open-ephys/onix-headstage-64s/README.md

# ONIX Simplified 64-Channel Headstage
Serialized, multifunction headstage for wire electrode or silicon probe recordings.

- 64x electrophysiology channels
- 3x auxiliary analog channels
- Integrated real-time, room-scale 3D-position tracking
- Integrated absolute orientation tracking
