open-ephys/onix-headstage-64s/pcb/manufacturing/pcb-fabrication-specs.md

# PCB Fabrication Specifications

## Panel
- Fabricator makes panel as 1x5 with V-Cuts
- Fabricator adds frame and fiducial marks
- Fabricator markings allowed on frame

## Stackup
- layer "F.Cu" 
    - type "copper" 
    - Thickness 0.035 mm
- layer "Dielectric 1" 
    - type "prepreg" 
    - Thickness 0.112 mm 
- layer "In1.Cu" 
    - type "copper" 
    - Thickness 0.035 mm
- layer "Dielectric 2" 
    - type "prepreg" 
    - Thickness 0.0329 mm 
- layer "In2.Cu" 
    - type "copper" 
    - Thickness 0.035 mm
- layer "Dielectric 3" 
    - type "core" 
    - Thickness 0.0656 mm 
- layer "In3.Cu" 
    - type "copper" 
    - Thickness 0.035 mm
- layer "Dielectric 4" 
    - type "prepreg" 
    - Thickness 0.0329 mm 
- layer "In4.Cu" 
    - type "copper" 
    - Thickness 0.035 mm
- layer "Dielectric 5" 
    - type "prepreg 
    - Thickness 0.112 mm 
- layer "B.Cu" 
    - type "copper" 
    - Thickness 0.035 mm

- Total thickness: ~0.6mm

## Trace space
- Trace: 0.0762 mm
- Space: 0.0762 mm

## Vias
- Through vias: 241
- Blind/buried: 0
- Micro vias: 0
- VIP
- Vias are epoxy-filled and and plated over

## Drill holes
| Count | Shape | X Size | Y Size | Plated | Via/Pad | Start Layer | Stop Layer |
|---|---|---|---|---|---|---|---|
| 200 | Round | 0.1000 mm | 0.1000 mm | PTH | Via | F.Cu | B.Cu |
| 41 | Round | 0.2000 mm | 0.2000 mm | PTH | Via | F.Cu | B.Cu |
| 10 | Round | 1.0000 mm | 1.0000 mm | PTH | Pad | F.Cu | B.Cu |
