open-ephys/onix-headstage-64s/(threads)

Thread 1 (2024-02-23):

Fix BNO055 symbol error

jonnew, 2024-02-23:
As noted in [this commit ](https://github.com/open-ephys/open-ephys-kicad-library/commit/a86a1528330b028d3558035a07ae2cf99dc39085), the official KiCAD BNO055 symbol had a major error that ended up tying two pins (15 and 16) to ground that should be DNC. This needs to be fixed in the schematic, pcb, and production files and will result in a new PCB revision.

Closed 2025-02-04.
