open-ephys/onix-headstage-64s/pcb/headstage-64s.pdf

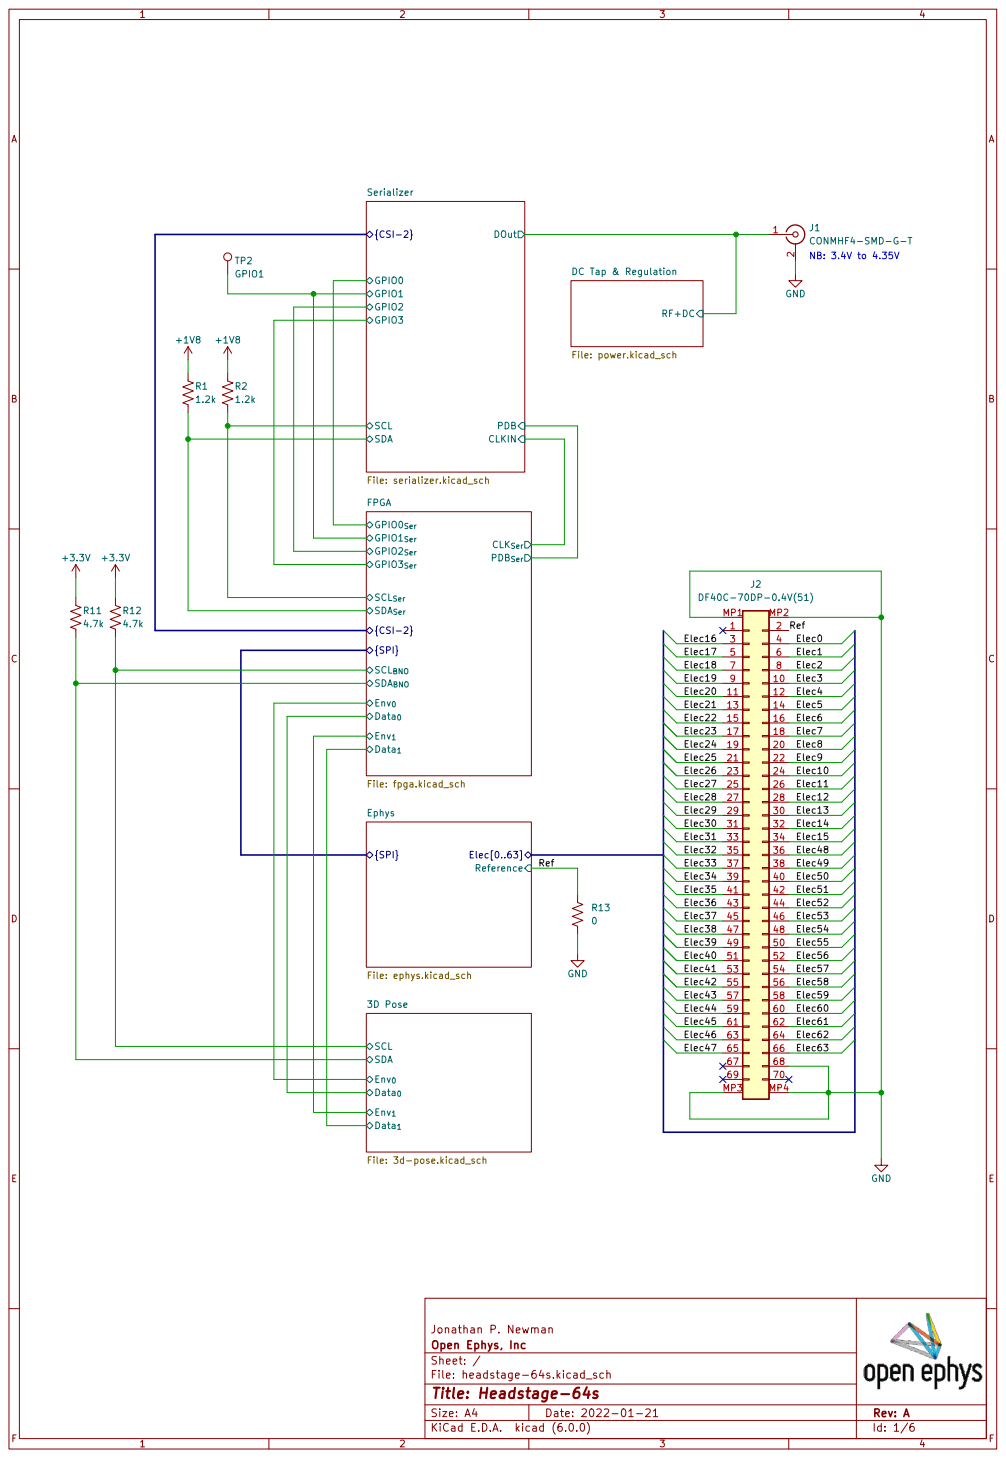
[picture p1: page 1]

Jonathan P. Newman SCL SDA

File: headstage-64s.kicad_sch Sheet: / Open Ephys, Inc

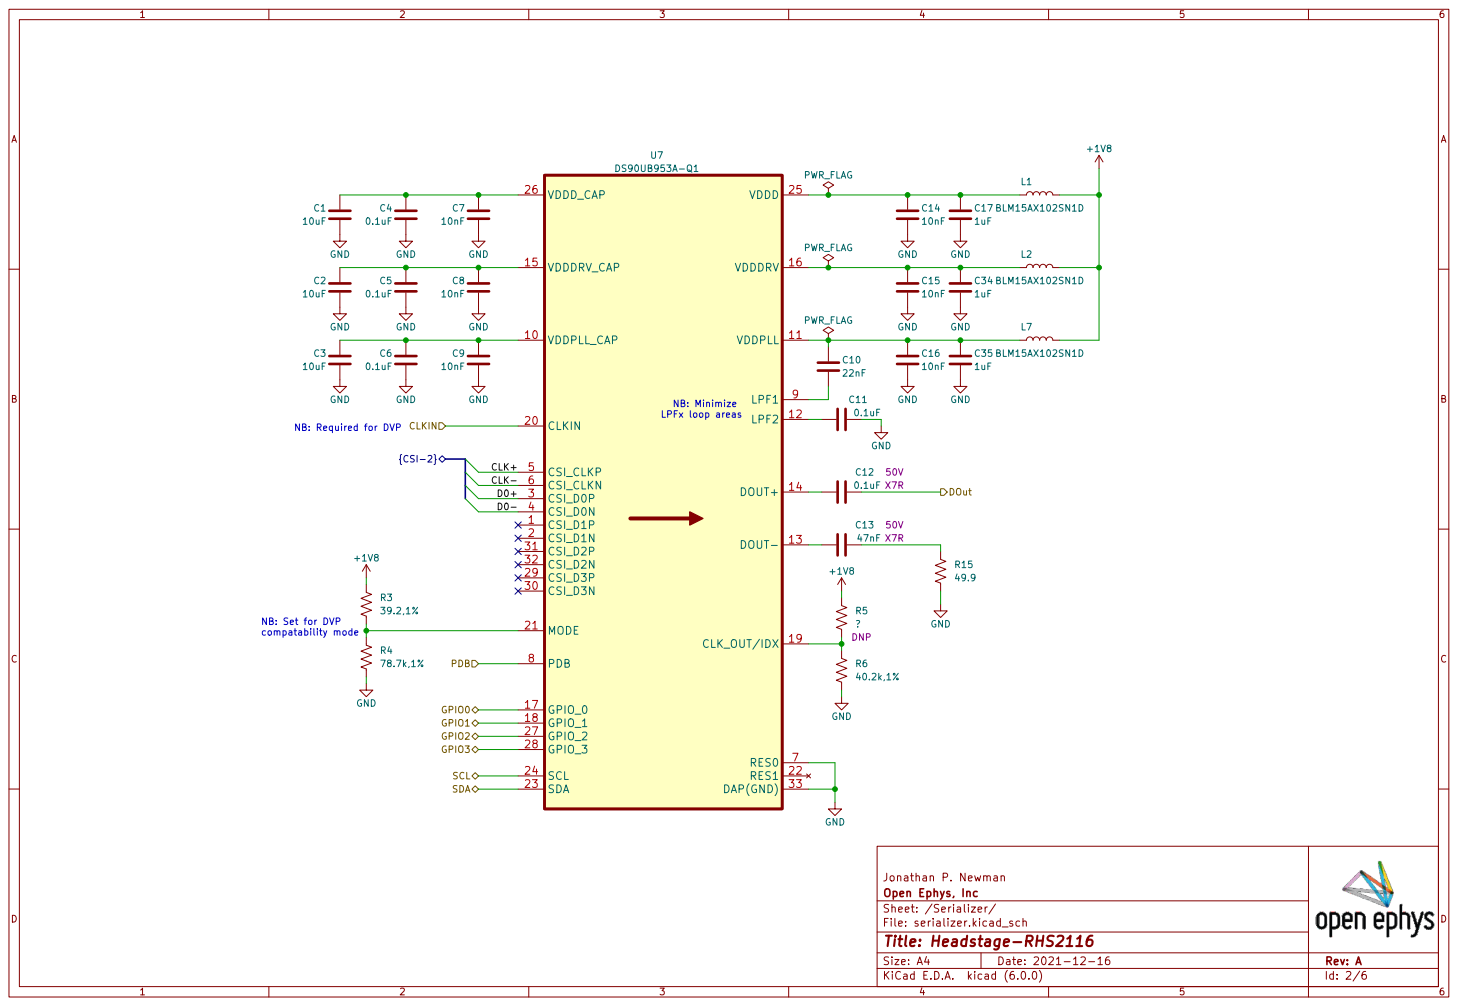
[picture p2: page 2]

PWR_FLAG | 1uF C14

1uF GND

Jonathan P. Newman GND GND

File: serializer.kicad_sch Sheet: /Serializer/ Open Ephys, Inc

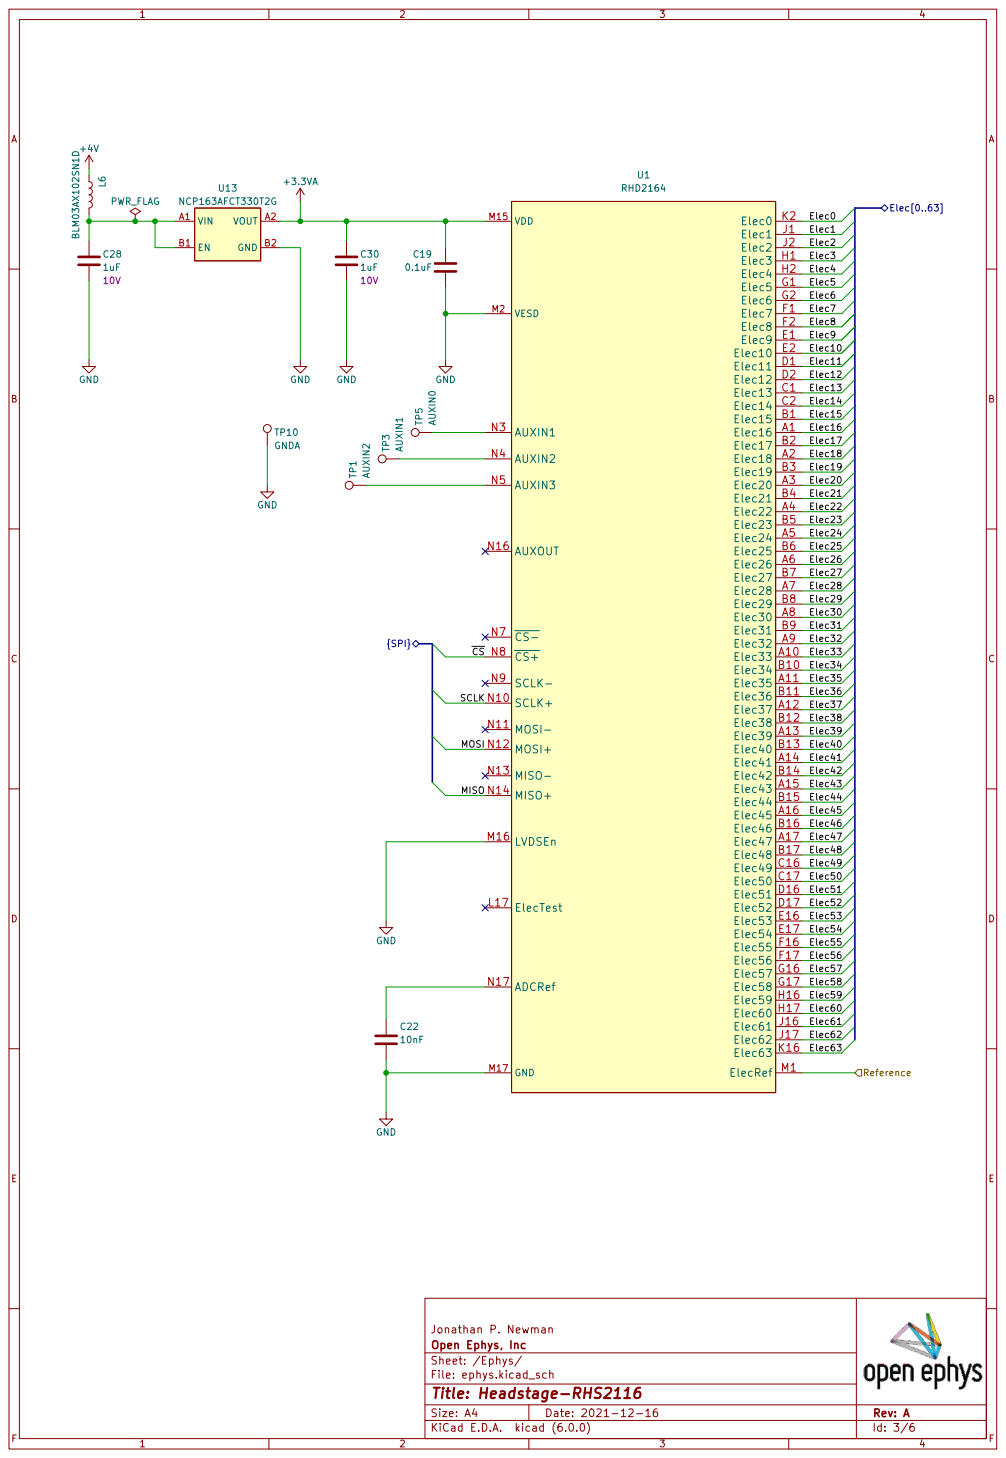
[picture p3: page 3]

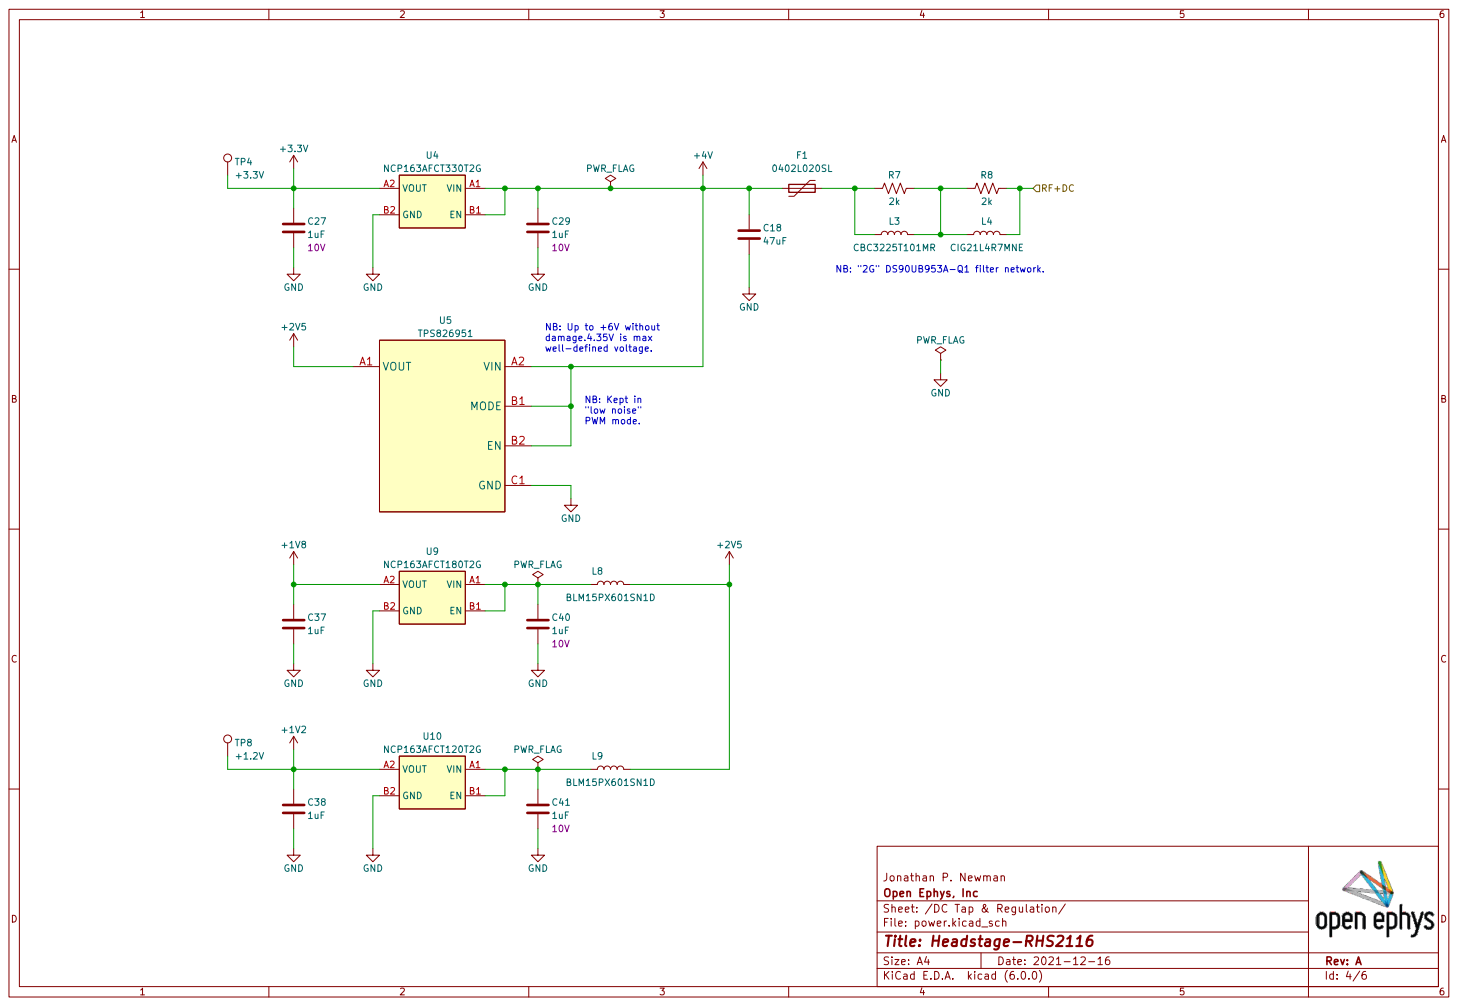
[picture p4: page 4]

NB: Up to +6V without
damage.4.35V is max

"low noise" PWM mode.

Open Ephys, Inc
Sheet: /DC Tap & Regulation/
File: power.kicad_sch
Id: 4/6 Title: Headstage-RHS2116

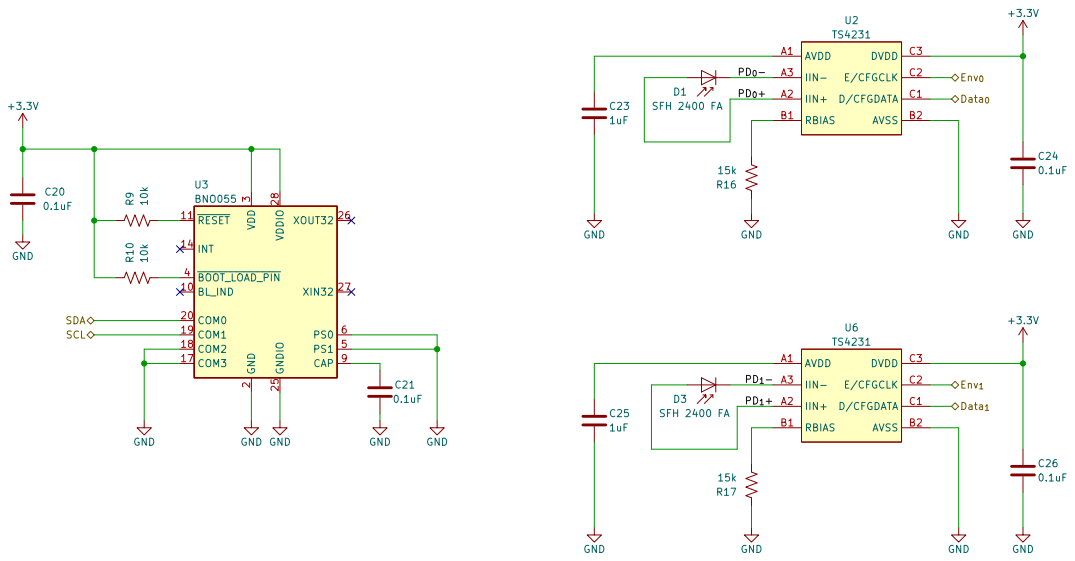
[picture p5: page 5]

File: 3d-pose.kicad_sch Sheet: /3D Pose/ Open Ephys, Inc

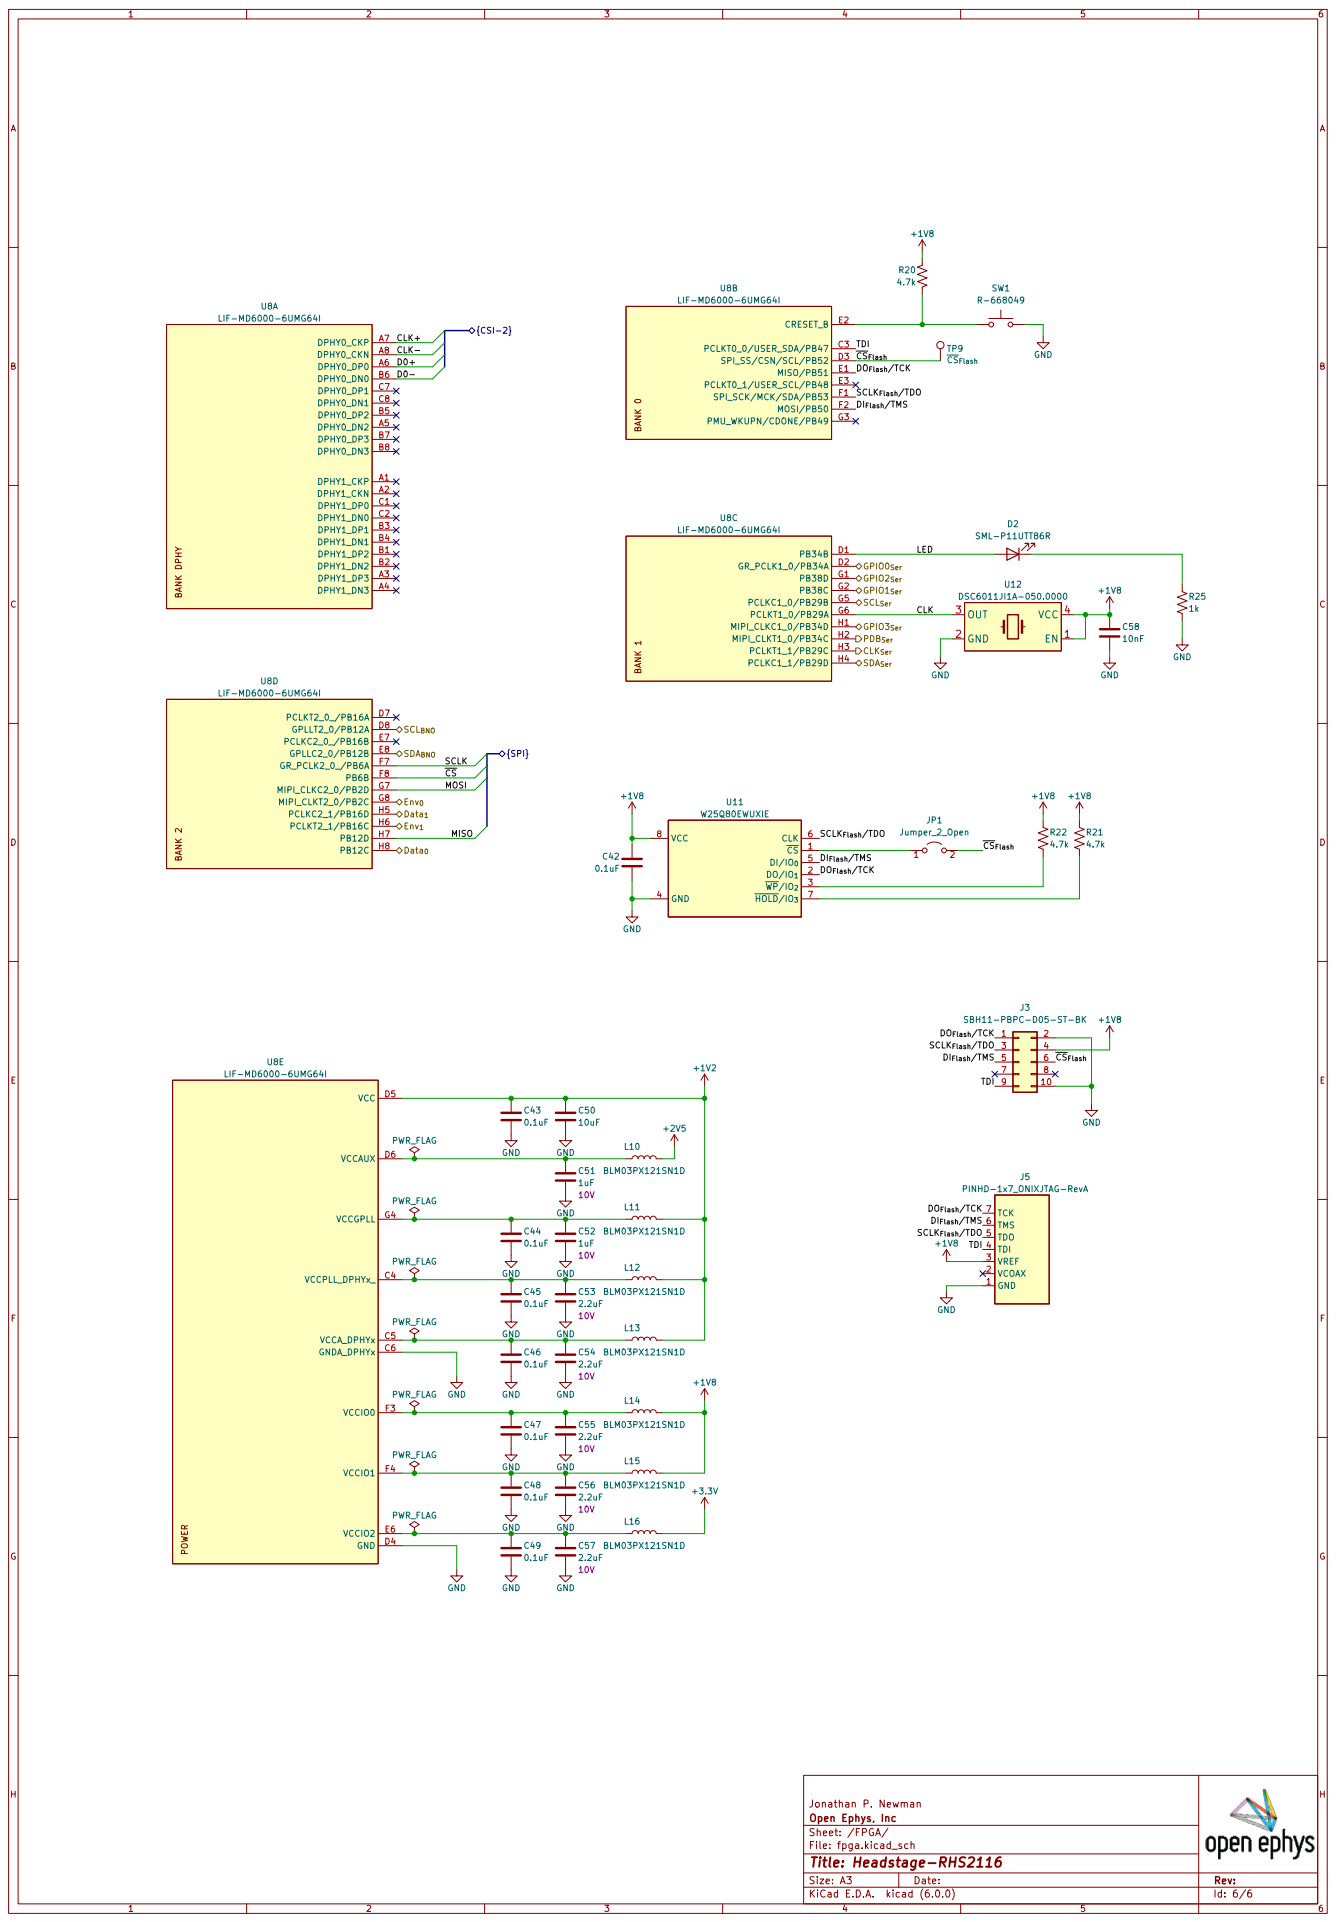
[picture p6: page 6]

SCL_{BNO}
SCLK MOSI ~{CS} MISO

PWR_FLAG | 0.1uF C45

PWR_FLAG | | 10V GND

Jonathan P. Newman
File: fpga.kicad_sch Sheet: /FPGA/ Open Ephys, Inc
