open-ephys/onix-headstage-64s/pcb/headstage-64s.kicad_pcb

## KiCad design pcb/headstage-64s.kicad_pcb (2022-12-06)

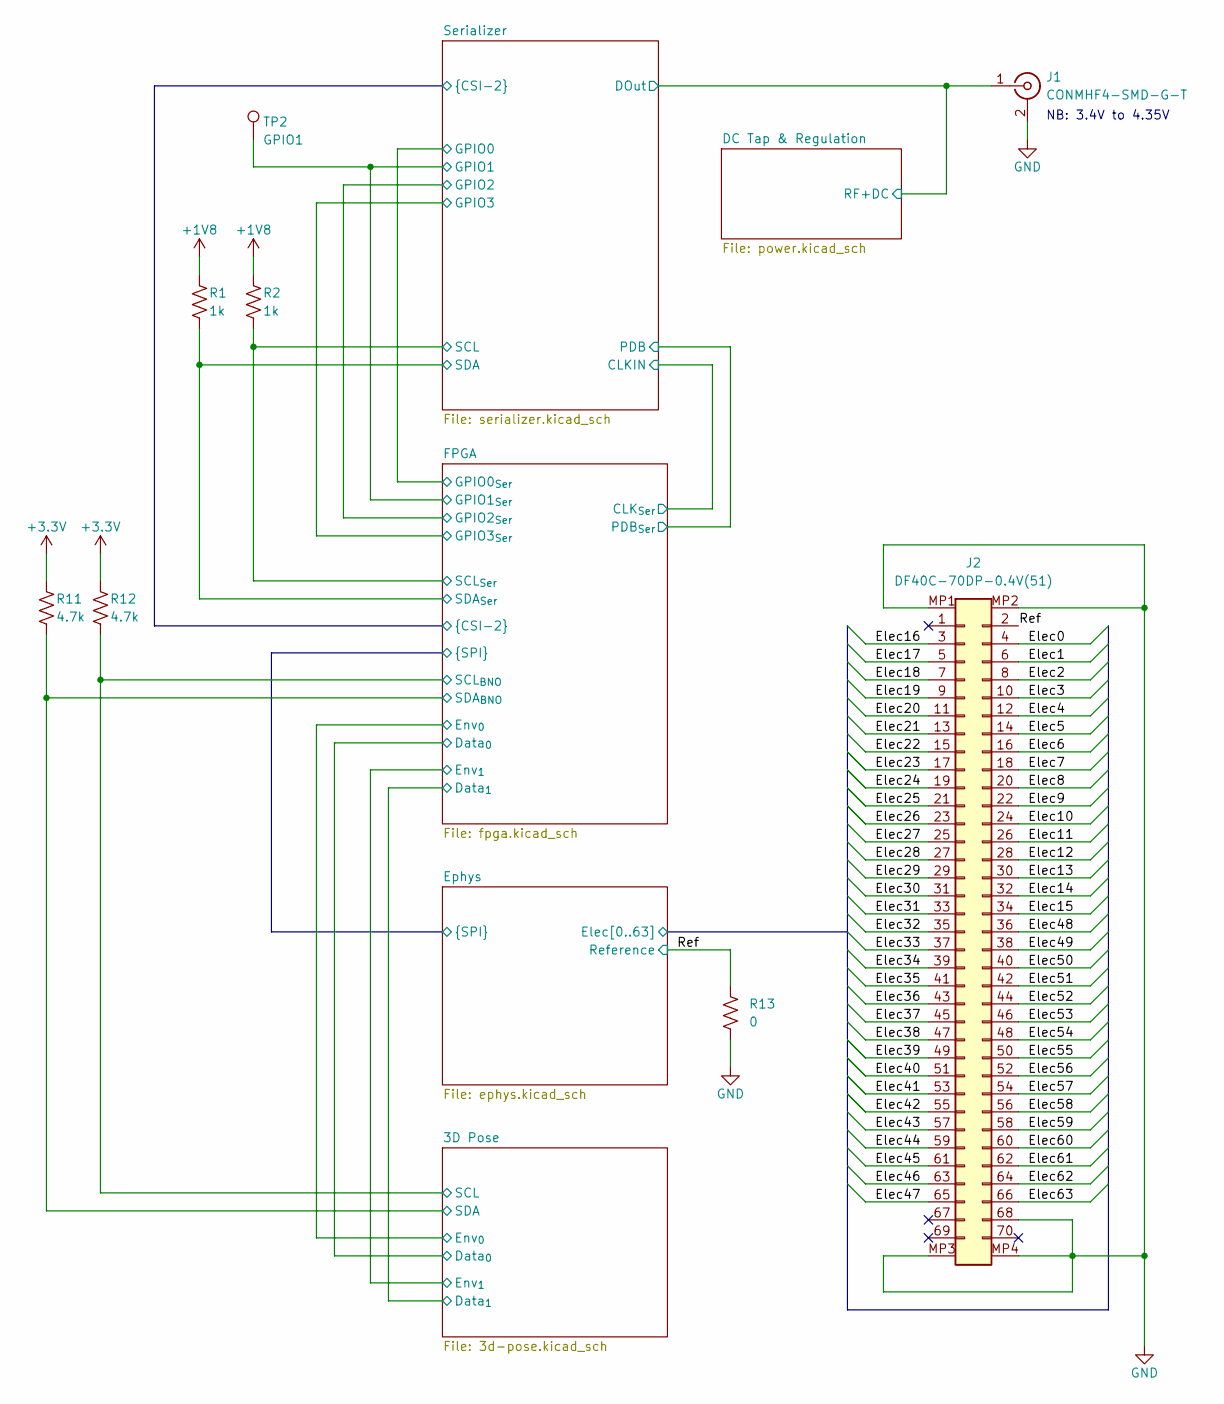
[picture p7: schematic headstage-64s.kicad_sch]

Parts:
J1: CONMHF4-SMD-G-T; Coax-Adapter
J2: DF40C-70DP-0.4V(51); HIROSE_DF40C70DP04V51
R1, R2: 1k; R_0201_0603Metric
R11, R12: 4.7k; R_0201_0603Metric
R13: 0; R_0201_0603Metric
TP2: GPIO1; TestPoint_Pad_D0.6mm

Connections:
+1V8: R1.1, R2.1; also elsewhere on the board
+3V3: R11.1, R12.1; also elsewhere on the board
/3D Pose/SCL: R12.2; also elsewhere on the board
/3D Pose/SDA: R11.2; also elsewhere on the board
/DC Tap & Regulation/RF+DC: J1.1 (In); also elsewhere on the board
/Ephys/Elec0: J2.4; also elsewhere on the board
/Ephys/Elec1: J2.6; also elsewhere on the board
/Ephys/Elec2: J2.8; also elsewhere on the board
/Ephys/Elec3: J2.10; also elsewhere on the board
/Ephys/Elec4: J2.12; also elsewhere on the board
/Ephys/Elec5: J2.14; also elsewhere on the board
/Ephys/Elec6: J2.16; also elsewhere on the board
/Ephys/Elec7: J2.18; also elsewhere on the board
/Ephys/Elec8: J2.20; also elsewhere on the board
/Ephys/Elec9: J2.22; also elsewhere on the board
/Ephys/Elec10: J2.24; also elsewhere on the board
/Ephys/Elec11: J2.26; also elsewhere on the board
/Ephys/Elec12: J2.28; also elsewhere on the board
/Ephys/Elec13: J2.30; also elsewhere on the board
/Ephys/Elec14: J2.32; also elsewhere on the board
/Ephys/Elec15: J2.34; also elsewhere on the board
/Ephys/Elec16: J2.3; also elsewhere on the board
/Ephys/Elec17: J2.5; also elsewhere on the board
/Ephys/Elec18: J2.7; also elsewhere on the board
/Ephys/Elec19: J2.9; also elsewhere on the board
/Ephys/Elec20: J2.11; also elsewhere on the board
/Ephys/Elec21: J2.13; also elsewhere on the board
/Ephys/Elec22: J2.15; also elsewhere on the board
/Ephys/Elec23: J2.17; also elsewhere on the board
/Ephys/Elec24: J2.19; also elsewhere on the board
/Ephys/Elec25: J2.21; also elsewhere on the board
/Ephys/Elec26: J2.23; also elsewhere on the board
/Ephys/Elec27: J2.25; also elsewhere on the board
/Ephys/Elec28: J2.27; also elsewhere on the board
/Ephys/Elec29: J2.29; also elsewhere on the board
/Ephys/Elec30: J2.31; also elsewhere on the board
/Ephys/Elec31: J2.33; also elsewhere on the board
/Ephys/Elec32: J2.35; also elsewhere on the board
/Ephys/Elec33: J2.37; also elsewhere on the board
/Ephys/Elec34: J2.39; also elsewhere on the board
/Ephys/Elec35: J2.41; also elsewhere on the board
/Ephys/Elec36: J2.43; also elsewhere on the board
/Ephys/Elec37: J2.45; also elsewhere on the board
/Ephys/Elec38: J2.47; also elsewhere on the board
/Ephys/Elec39: J2.49; also elsewhere on the board
/Ephys/Elec40: J2.51; also elsewhere on the board
/Ephys/Elec41: J2.53; also elsewhere on the board
/Ephys/Elec42: J2.55; also elsewhere on the board
/Ephys/Elec43: J2.57; also elsewhere on the board
/Ephys/Elec44: J2.59; also elsewhere on the board
/Ephys/Elec45: J2.61; also elsewhere on the board
/Ephys/Elec46: J2.63; also elsewhere on the board
/Ephys/Elec47: J2.65; also elsewhere on the board
/Ephys/Elec48: J2.36; also elsewhere on the board
/Ephys/Elec49: J2.38; also elsewhere on the board
/Ephys/Elec50: J2.40; also elsewhere on the board
/Ephys/Elec51: J2.42; also elsewhere on the board
/Ephys/Elec52: J2.44; also elsewhere on the board
/Ephys/Elec53: J2.46; also elsewhere on the board
/Ephys/Elec54: J2.48; also elsewhere on the board
/Ephys/Elec55: J2.50; also elsewhere on the board
/Ephys/Elec56: J2.52; also elsewhere on the board
/Ephys/Elec57: J2.54; also elsewhere on the board
/Ephys/Elec58: J2.56; also elsewhere on the board
/Ephys/Elec59: J2.58; also elsewhere on the board
/Ephys/Elec60: J2.60; also elsewhere on the board
/Ephys/Elec61: J2.62; also elsewhere on the board
/Ephys/Elec62: J2.64; also elsewhere on the board
/Ephys/Elec63: J2.66; also elsewhere on the board
/FPGA/GPIO1_{Ser}: TP2.1; also elsewhere on the board
/FPGA/SCL_{Ser}: R2.2; also elsewhere on the board
/FPGA/SDA_{Ser}: R1.2; also elsewhere on the board
/Ref: J2.2, R13.1; also elsewhere on the board
GND: J1.2 (Ext), J2.68, J2.MP1 (MountPin1), J2.MP2 (MountPin2), J2.MP3 (MountPin3), J2.MP4 (MountPin4), R13.2; also elsewhere on the board

Notes on the sheet:
NB: 3.4V to 4.35V

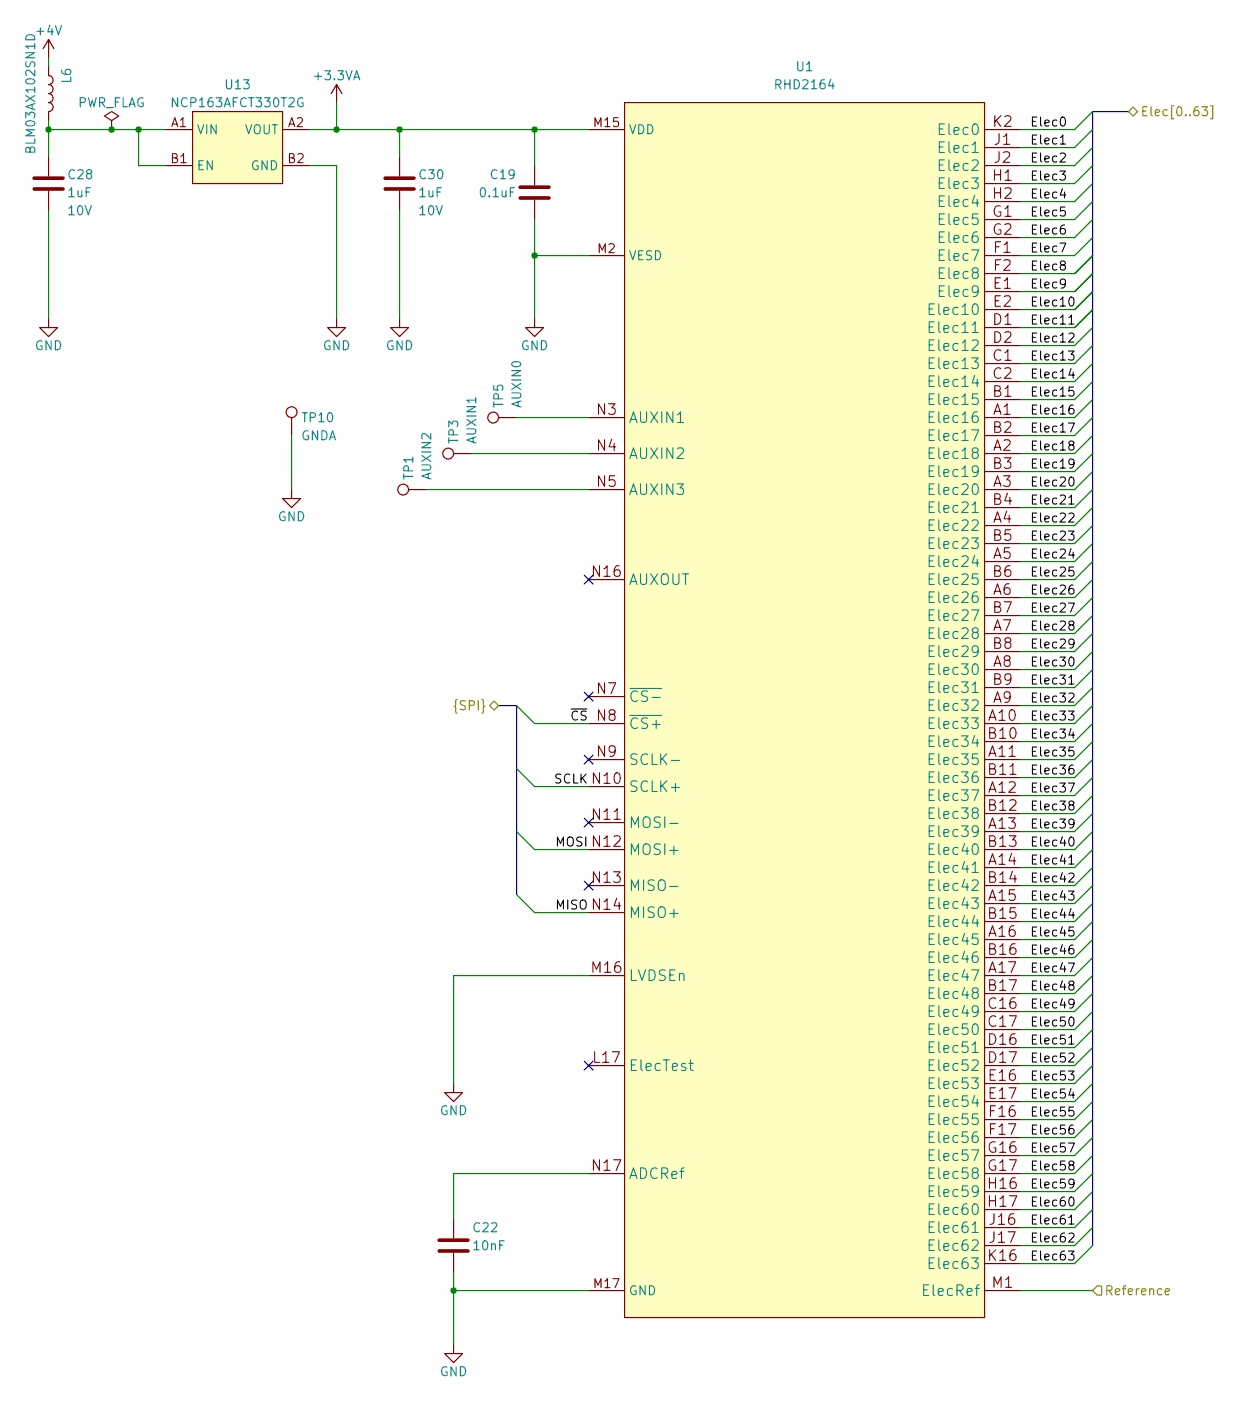
[picture p8: schematic ephys.kicad_sch, Headstage-64s]

Parts:
C19: 0.1uF; C_0201_0603Metric; Voltage 16V
C22: 10nF; C_0201_0603Metric; Voltage 35V
C28, C30: 1uF; C_0201_0603Metric; Voltage 10V
L6: BLM03AX102SN1D; L_0201_0603Metric
TP1: AUXIN2; TestPoint_Pad_D0.6mm
TP3: AUXIN1; TestPoint_Pad_D0.6mm
TP5: AUXIN0; TestPoint_Pad_D0.6mm
TP10: GNDA; TestPoint_Pad_D0.6mm
U1: RHD2164; INTAN_BGA-100_17x13_9.0x7.0mm
U13: NCP163AFCT330T2G; ONSEMI_567JZ_WLCSP4-0.64x0.64

Connections:
+3.3VA: C19.1, C30.1, U1.M15 (VDD), U1.N2 (VDD), U1.N15 (VDD), U13.A2 (VOUT)
+4V: L6.1; also elsewhere on the board
/Ephys/Elec0: U1.K2 (Elec0); also elsewhere on the board
/Ephys/Elec1: U1.J1 (Elec1); also elsewhere on the board
/Ephys/Elec2: U1.J2 (Elec2); also elsewhere on the board
/Ephys/Elec3: U1.H1 (Elec3); also elsewhere on the board
/Ephys/Elec4: U1.H2 (Elec4); also elsewhere on the board
/Ephys/Elec5: U1.G1 (Elec5); also elsewhere on the board
/Ephys/Elec6: U1.G2 (Elec6); also elsewhere on the board
/Ephys/Elec7: U1.F1 (Elec7); also elsewhere on the board
/Ephys/Elec8: U1.F2 (Elec8); also elsewhere on the board
/Ephys/Elec9: U1.E1 (Elec9); also elsewhere on the board
/Ephys/Elec10: U1.E2 (Elec10); also elsewhere on the board
/Ephys/Elec11: U1.D1 (Elec11); also elsewhere on the board
/Ephys/Elec12: U1.D2 (Elec12); also elsewhere on the board
/Ephys/Elec13: U1.C1 (Elec13); also elsewhere on the board
/Ephys/Elec14: U1.C2 (Elec14); also elsewhere on the board
/Ephys/Elec15: U1.B1 (Elec15); also elsewhere on the board
/Ephys/Elec16: U1.A1 (Elec16); also elsewhere on the board
/Ephys/Elec17: U1.B2 (Elec17); also elsewhere on the board
/Ephys/Elec18: U1.A2 (Elec18); also elsewhere on the board
/Ephys/Elec19: U1.B3 (Elec19); also elsewhere on the board
/Ephys/Elec20: U1.A3 (Elec20); also elsewhere on the board
/Ephys/Elec21: U1.B4 (Elec21); also elsewhere on the board
/Ephys/Elec22: U1.A4 (Elec22); also elsewhere on the board
/Ephys/Elec23: U1.B5 (Elec23); also elsewhere on the board
/Ephys/Elec24: U1.A5 (Elec24); also elsewhere on the board
/Ephys/Elec25: U1.B6 (Elec25); also elsewhere on the board
/Ephys/Elec26: U1.A6 (Elec26); also elsewhere on the board
/Ephys/Elec27: U1.B7 (Elec27); also elsewhere on the board
/Ephys/Elec28: U1.A7 (Elec28); also elsewhere on the board
/Ephys/Elec29: U1.B8 (Elec29); also elsewhere on the board
/Ephys/Elec30: U1.A8 (Elec30); also elsewhere on the board
/Ephys/Elec31: U1.B9 (Elec31); also elsewhere on the board
/Ephys/Elec32: U1.A9 (Elec32); also elsewhere on the board
/Ephys/Elec33: U1.A10 (Elec33); also elsewhere on the board
/Ephys/Elec34: U1.B10 (Elec34); also elsewhere on the board
/Ephys/Elec35: U1.A11 (Elec35); also elsewhere on the board
/Ephys/Elec36: U1.B11 (Elec36); also elsewhere on the board
/Ephys/Elec37: U1.A12 (Elec37); also elsewhere on the board
/Ephys/Elec38: U1.B12 (Elec38); also elsewhere on the board
/Ephys/Elec39: U1.A13 (Elec39); also elsewhere on the board
/Ephys/Elec40: U1.B13 (Elec40); also elsewhere on the board
/Ephys/Elec41: U1.A14 (Elec41); also elsewhere on the board
/Ephys/Elec42: U1.B14 (Elec42); also elsewhere on the board
/Ephys/Elec43: U1.A15 (Elec43); also elsewhere on the board
/Ephys/Elec44: U1.B15 (Elec44); also elsewhere on the board
/Ephys/Elec45: U1.A16 (Elec45); also elsewhere on the board
/Ephys/Elec46: U1.B16 (Elec46); also elsewhere on the board
/Ephys/Elec47: U1.A17 (Elec47); also elsewhere on the board
/Ephys/Elec48: U1.B17 (Elec48); also elsewhere on the board
/Ephys/Elec49: U1.C16 (Elec49); also elsewhere on the board
/Ephys/Elec50: U1.C17 (Elec50); also elsewhere on the board
/Ephys/Elec51: U1.D16 (Elec51); also elsewhere on the board
/Ephys/Elec52: U1.D17 (Elec52); also elsewhere on the board
/Ephys/Elec53: U1.E16 (Elec53); also elsewhere on the board
/Ephys/Elec54: U1.E17 (Elec54); also elsewhere on the board
/Ephys/Elec55: U1.F16 (Elec55); also elsewhere on the board
/Ephys/Elec56: U1.F17 (Elec56); also elsewhere on the board
/Ephys/Elec57: U1.G16 (Elec57); also elsewhere on the board
/Ephys/Elec58: U1.G17 (Elec58); also elsewhere on the board
/Ephys/Elec59: U1.H16 (Elec59); also elsewhere on the board
/Ephys/Elec60: U1.H17 (Elec60); also elsewhere on the board
/Ephys/Elec61: U1.J16 (Elec61); also elsewhere on the board
/Ephys/Elec62: U1.J17 (Elec62); also elsewhere on the board
/Ephys/Elec63: U1.K16 (Elec63); also elsewhere on the board
/Ephys/MISO: U1.N14 (MISO+); also elsewhere on the board
/Ephys/MOSI: U1.N12 (MOSI+); also elsewhere on the board
/Ephys/SCLK: U1.N10 (SCLK+); also elsewhere on the board
/Ephys/~CS: U1.N8 (~CS+); also elsewhere on the board
/Ref: U1.M1 (ElecRef); also elsewhere on the board
GND: C19.2, C22.2, C28.2, C30.2, TP10.1, U1.M2 (VESD), U1.M16 (LVDSEn), U1.M17 (GND), U1.N1 (GND), U1.N6 (GND), U13.B2 (GND); also elsewhere on the board
unnamed: C22.1, U1.N17 (ADCRef)
unnamed: C28.1, L6.2, U13.A1 (VIN), U13.B1 (EN)
unnamed: TP1.1, U1.N5 (AUXIN3)
unnamed: TP3.1, U1.N4 (AUXIN2)
unnamed: TP5.1, U1.N3 (AUXIN1)

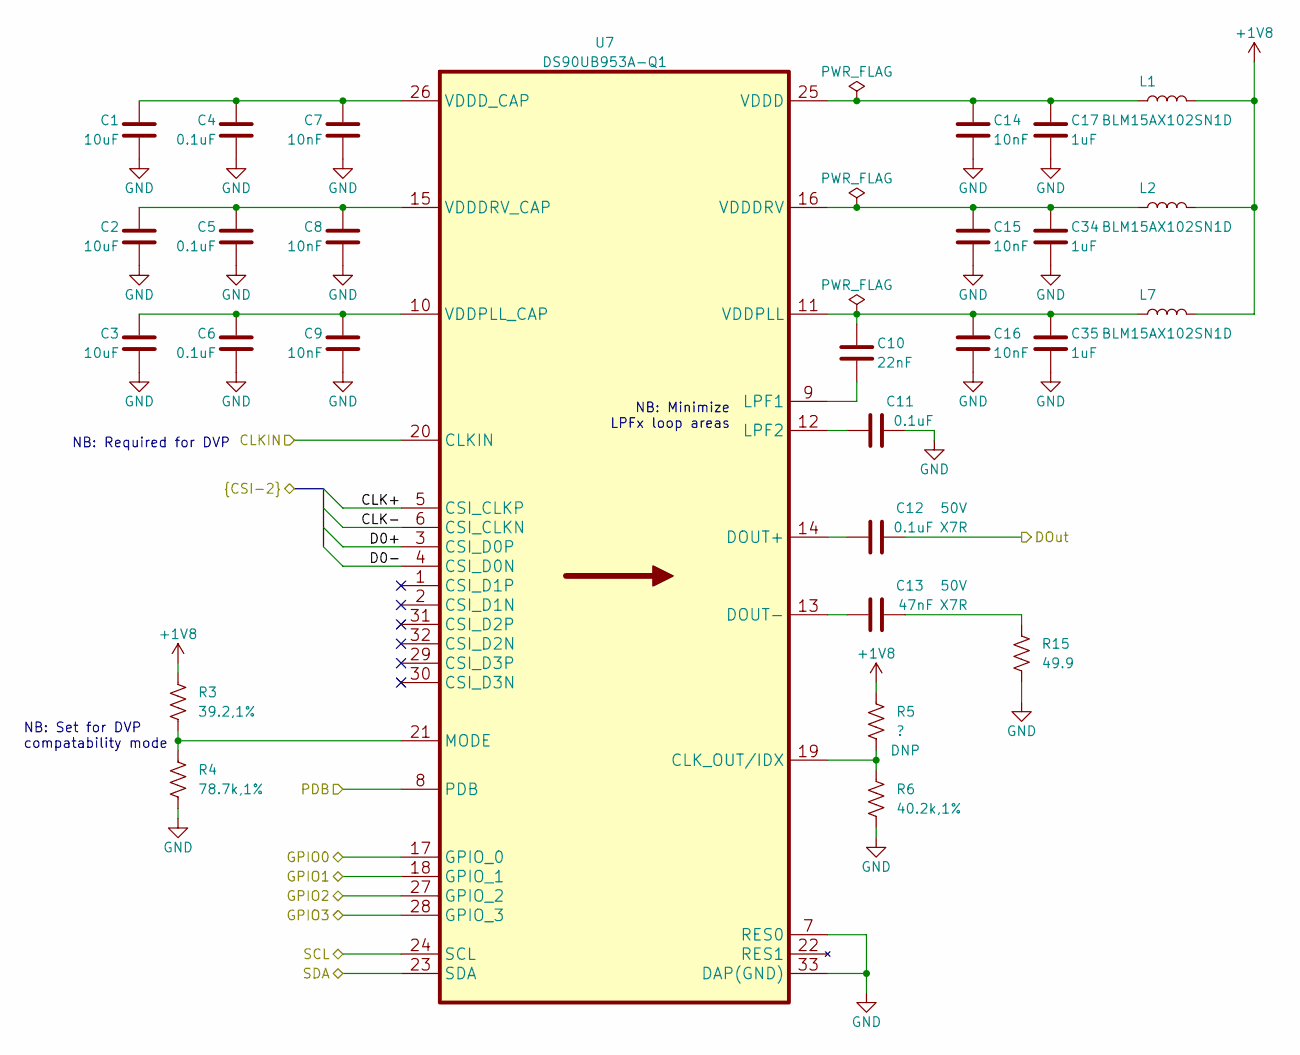
[picture p9: schematic serializer.kicad_sch, Headstage-64s]

Parts:
C1, C2, C3: 10uF; C_0402_1005Metric; Voltage 10V
C4, C5, C6, C11: 0.1uF; C_0201_0603Metric; Voltage 16V
C7, C8, C9, C14, C15, C16: 10nF; C_0201_0603Metric; Voltage 35V
C10: 22nF; C_0402_1005Metric; Voltage 35V
C12: 0.1uF; C_0402_1005Metric; Voltage 50V
C13: 47nF; C_0402_1005Metric; Voltage 50V
C17, C34, C35: 1uF; C_0402_1005Metric; Voltage 16V
L1, L2, L7: BLM15AX102SN1D; L_0402_1005Metric
R3: 39.2,1%; R_0201_0603Metric
R4: 78.7k,1%; R_0201_0603Metric
R5: ?; R_0201_0603Metric
R6: 40.2k,1%; R_0201_0603Metric
R15: 49.9; R_0201_0603Metric
U7: DS90UB953A-Q1; TI_RHB0032P

Connections:
+1V8: L1.2, L2.2, L7.2, R3.1, R5.1; also elsewhere on the board
/DC Tap & Regulation/RF+DC: C12.2; also elsewhere on the board
/FPGA/CLK+: U7.5 (CSI_CLKP); also elsewhere on the board
/FPGA/CLK-: U7.6 (CSI_CLKN); also elsewhere on the board
/FPGA/CLK_{Ser}: U7.20 (CLKIN); also elsewhere on the board
/FPGA/D0+: U7.3 (CSI_D0P); also elsewhere on the board
/FPGA/D0-: U7.4 (CSI_D0N); also elsewhere on the board
/FPGA/GPIO0_{Ser}: U7.17 (GPIO_0); also elsewhere on the board
/FPGA/GPIO1_{Ser}: U7.18 (GPIO_1); also elsewhere on the board
/FPGA/GPIO2_{Ser}: U7.27 (GPIO_2); also elsewhere on the board
/FPGA/GPIO3_{Ser}: U7.28 (GPIO_3); also elsewhere on the board
/FPGA/PDB_{Ser}: U7.8 (PDB); also elsewhere on the board
/FPGA/SCL_{Ser}: U7.24 (SCL); also elsewhere on the board
/FPGA/SDA_{Ser}: U7.23 (SDA); also elsewhere on the board
GND: C1.2, C2.2, C3.2, C4.2, C5.2, C6.2, C7.2, C8.2, C9.2, C11.2, C14.2, C15.2, C16.2, C17.2, C34.2, C35.2, R4.2, R6.2, R15.2, U7.7 (RES0), U7.33 (DAP(GND)); also elsewhere on the board
unnamed: C1.1, C4.1, C7.1, U7.26 (VDDD_CAP)
unnamed: C2.1, C5.1, C8.1, U7.15 (VDDDRV_CAP)
unnamed: C3.1, C6.1, C9.1, U7.10 (VDDPLL_CAP)
unnamed: C10.1, C16.1, C35.1, L7.1, U7.11 (VDDPLL)
unnamed: C10.2, U7.9 (LPF1)
unnamed: C11.1, U7.12 (LPF2)
unnamed: C12.1, U7.14 (DOUT+)
unnamed: C13.1, U7.13 (DOUT-)
unnamed: C13.2, R15.1
unnamed: C14.1, C17.1, L1.1, U7.25 (VDDD)
unnamed: C15.1, C34.1, L2.1, U7.16 (VDDDRV)
unnamed: R3.2, R4.1, U7.21 (MODE)
unnamed: R5.2, R6.1, U7.19 (CLK_OUT/IDX)

Notes on the sheet:
NB: Set for DVP compatability mode
NB: Required for DVP
NB: Minimize LPFx loop areas

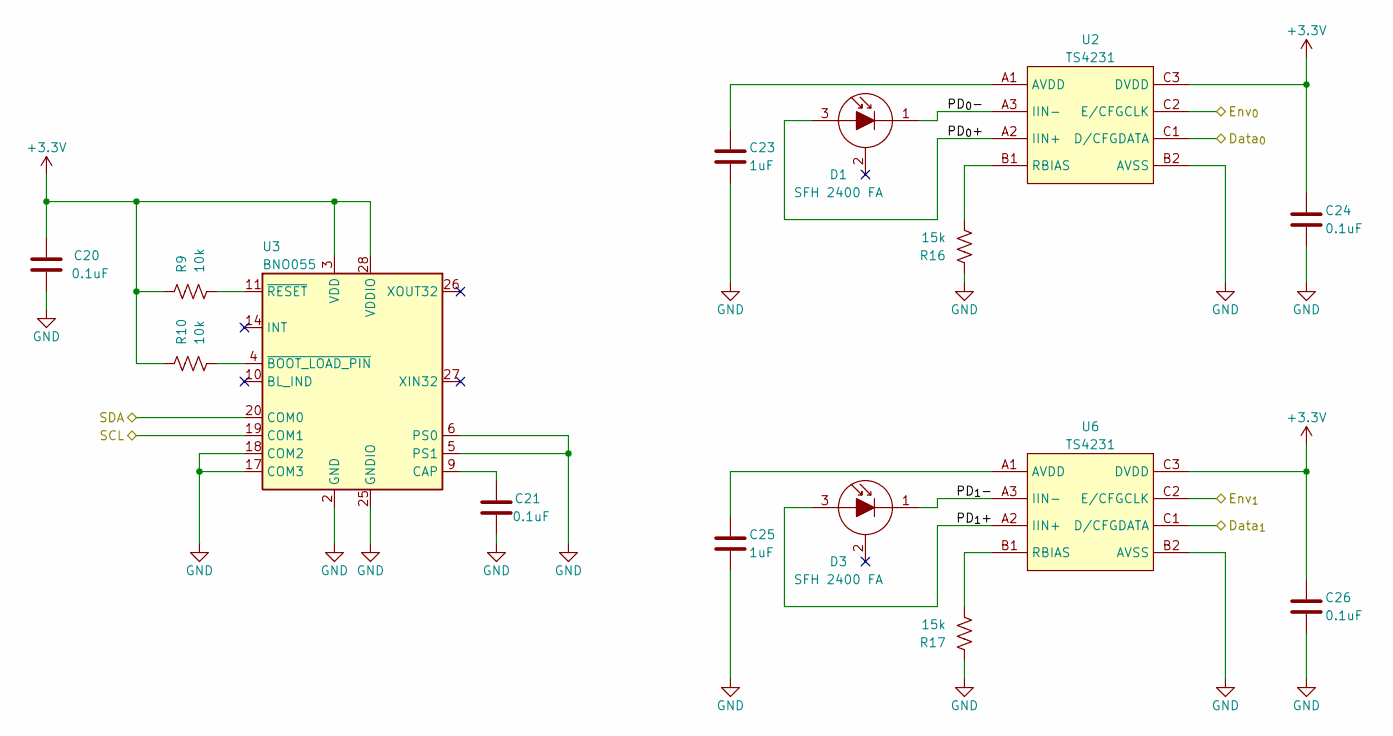
[picture p10: schematic 3d-pose.kicad_sch, Headstage-64s]

Parts:
C20, C21, C24, C26: 0.1uF; C_0201_0603Metric; Voltage 16V
C23, C25: 1uF; C_0402_1005Metric; Voltage 16V
D1, D3: SFH 2400 FA; OSRAM_SFH2400FA-Tight
R9, R10: 10k; R_0201_0603Metric
R16, R17: 15k; R_0201_0603Metric
U2, U6: TS4231; TRIAD_BGA-9_3x3_1.7x1.7mm
U3: BNO055; LGA-28_5.2x3.8mm_P0.5mm

Connections:
+3V3: C20.2, C24.2, C26.2, R9.1, R10.1, U2.C3 (DVDD), U3.3 (VDD), U3.28 (VDDIO), U6.C3 (DVDD); also elsewhere on the board
/3D Pose/Data_{0}: U2.C1 (D/CFGDATA); also elsewhere on the board
/3D Pose/Data_{1}: U6.C1 (D/CFGDATA); also elsewhere on the board
/3D Pose/Env_{0}: U2.C2 (E/CFGCLK); also elsewhere on the board
/3D Pose/Env_{1}: U6.C2 (E/CFGCLK); also elsewhere on the board
/3D Pose/PD_{0}+: D1.3 (A), U2.A2 (IIN+)
/3D Pose/PD_{0}-: D1.1 (K), U2.A3 (IIN-)
/3D Pose/PD_{1}+: D3.3 (A), U6.A2 (IIN+)
/3D Pose/PD_{1}-: D3.1 (K), U6.A3 (IIN-)
/3D Pose/SCL: U3.19 (COM1); also elsewhere on the board
/3D Pose/SDA: U3.20 (COM0); also elsewhere on the board
GND: C20.1, C21.1, C23.2, C24.1, C25.2, C26.1, R16.1, R17.1, U2.B2 (AVSS), U2.B3 (AVSS), U3.2 (GND), U3.5 (PS1), U3.6 (PS0), U3.15 (GNDIO), U3.16 (GNDIO), U3.17 (COM3), U3.18 (COM2), U3.25 (GNDIO), U6.B2 (AVSS), U6.B3 (AVSS); also elsewhere on the board
unnamed: C21.2, U3.9 (CAP)
unnamed: C23.1, U2.A1 (AVDD)
unnamed: C25.1, U6.A1 (AVDD)
unnamed: R9.2, U3.11 (~RESET)
unnamed: R10.2, U3.4 (~BOOT_LOAD_PIN)
unnamed: R16.2, U2.B1 (RBIAS)
unnamed: R17.2, U6.B1 (RBIAS)

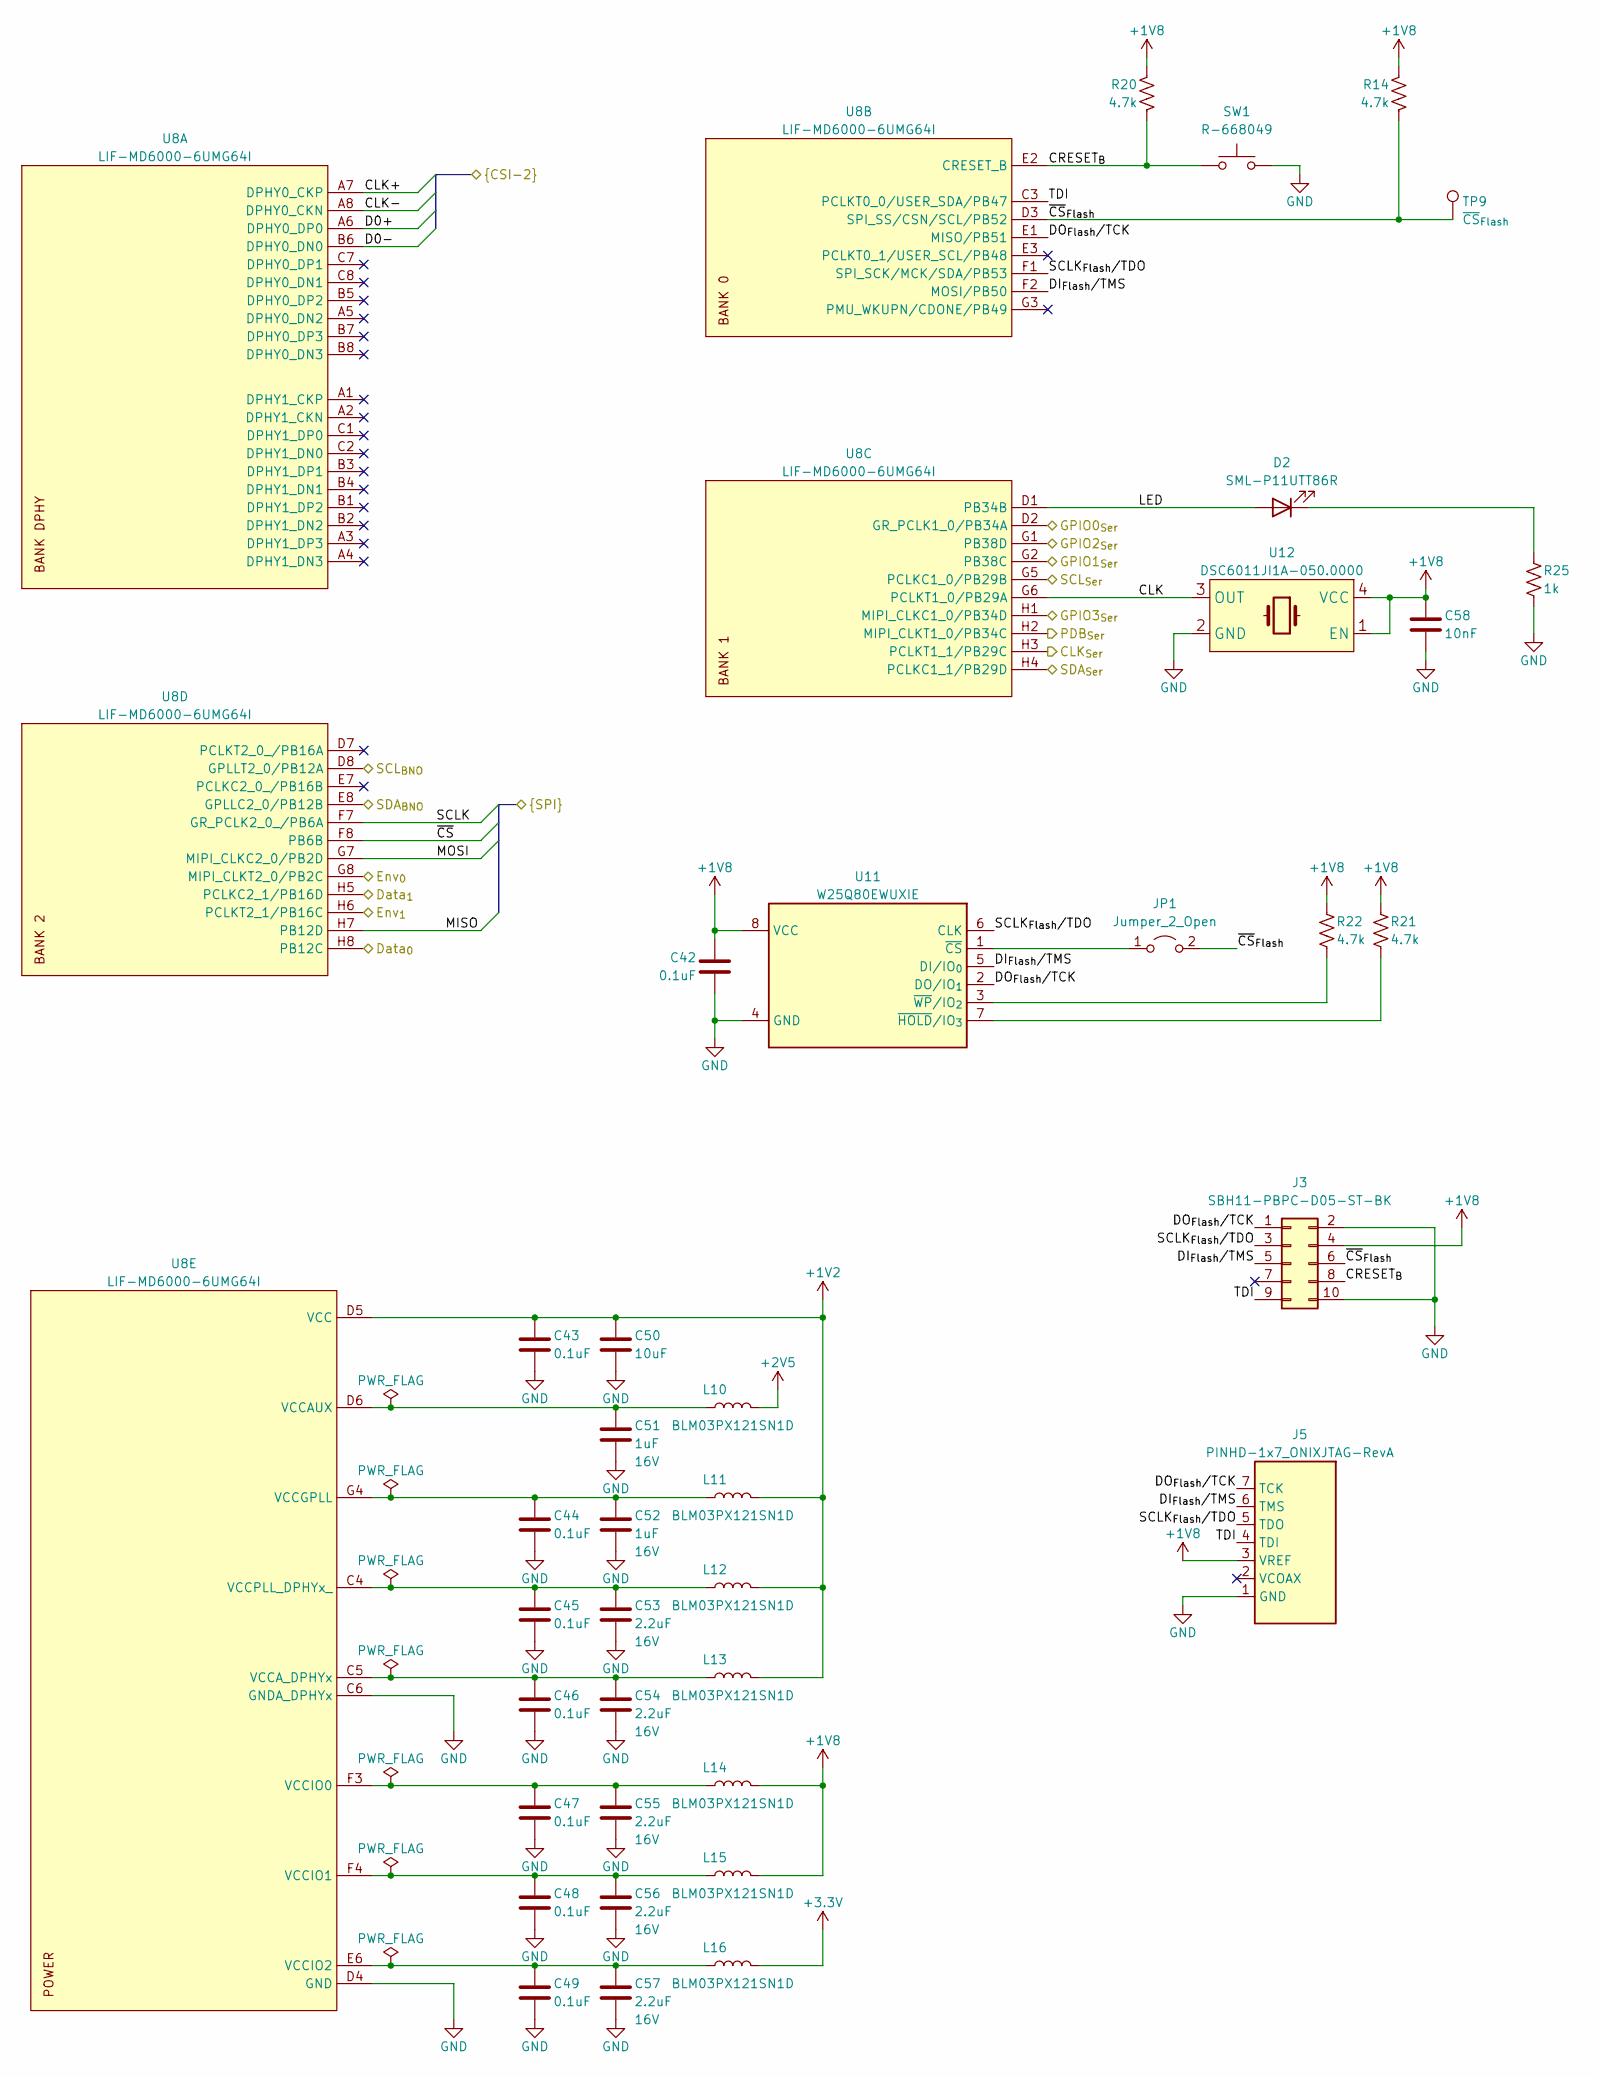
[picture p11: schematic fpga.kicad_sch, Headstage-64s]

Parts:
C42, C43, C44, C45, C46, C47, C48, C49: 0.1uF; C_0201_0603Metric; Voltage 16V
C50: 10uF; C_0402_1005Metric; Voltage 10V
C51, C52: 1uF; C_0402_1005Metric; Voltage 16V
C53, C54, C55, C56, C57: 2.2uF; C_0402_1005Metric; Voltage 16V
C58: 10nF; C_0201_0603Metric; Voltage 35V
D2: SML-P11UTT86R; ROHM_SML-P11MTT86R
J3: SBH11-PBPC-D05-ST-BK; IDC-Header_2x05_P2.54mm_Vertical
J5: PINHD-1x7_ONIXJTAG-RevA; ONIXJTAG-RevA
JP1: Jumper_2_Open; OE_SolderJumper-2_0201_Open_Pad
L10, L11, L12, L13, L14, L15, L16: BLM03PX121SN1D; L_0201_0603Metric
R14, R20, R21, R22: 4.7k; R_0201_0603Metric
R25: 1k; R_0201_0603Metric
SW1: R-668049; MITSUMI_R-668049
TP9: ~{CS}_{Flash}; TestPoint_Pad_D0.6mm
U8: LIF-MD6000-6UMG64I; LATTICE_ufcBGA64C40P8X8_3.5X3.5X1.0
U11: W25Q80EWUXIE; WINBOND_USON8-2x3x0.6
U12: DSC6011JI1A-050.0000; MICROCHIP_VFLGA4-2.0x1.6

Connections:
+1V2: C43.1, C50.1, L11.2, L12.2, L13.2, U8.D5 (VCC), U8.E4 (VCC); also elsewhere on the board
+1V8: C42.1, C58.1, J3.4, J5.3 (VREF), L14.2, L15.2, R14.1, R20.1, R21.1, R22.1, U11.8 (VCC), U12.1 (EN), U12.4 (VCC); also elsewhere on the board
+2V5: L10.2; also elsewhere on the board
+3V3: L16.2; also elsewhere on the board
/3D Pose/Data_{0}: U8.H8 (PB12C); also elsewhere on the board
/3D Pose/Data_{1}: U8.H5 (PCLKC2_1/PB16D); also elsewhere on the board
/3D Pose/Env_{0}: U8.G8 (MIPI_CLKT2_0/PB2C); also elsewhere on the board
/3D Pose/Env_{1}: U8.H6 (PCLKT2_1/PB16C); also elsewhere on the board
/3D Pose/SCL: U8.D8 (GPLLT2_0/PB12A); also elsewhere on the board
/3D Pose/SDA: U8.E8 (GPLLC2_0/PB12B); also elsewhere on the board
/Ephys/MISO: U8.H7 (PB12D); also elsewhere on the board
/Ephys/MOSI: U8.G7 (MIPI_CLKC2_0/PB2D); also elsewhere on the board
/Ephys/SCLK: U8.F7 (GR_PCLK2_0_/PB6A); also elsewhere on the board
/Ephys/~CS: U8.F8 (PB6B); also elsewhere on the board
/FPGA/CLK: U8.G6 (PCLKT1_0/PB29A), U12.3 (OUT)
/FPGA/CLK+: U8.A7 (DPHY0_CKP); also elsewhere on the board
/FPGA/CLK-: U8.A8 (DPHY0_CKN); also elsewhere on the board
/FPGA/CLK_{Ser}: U8.H3 (PCLKT1_1/PB29C); also elsewhere on the board
/FPGA/CRESET_{B}: J3.8, R20.2, SW1.1, U8.E2 (CRESET_B)
/FPGA/D0+: U8.A6 (DPHY0_DP0); also elsewhere on the board
/FPGA/D0-: U8.B6 (DPHY0_DN0); also elsewhere on the board
/FPGA/DI_{Flash}/TMS: J3.5, J5.6 (TMS), U8.F2 (MOSI/PB50), U11.5 (DI/IO_{0})
/FPGA/DO_{Flash}/TCK: J3.1, J5.7 (TCK), U8.E1 (MISO/PB51), U11.2 (DO/IO_{1})
/FPGA/GPIO0_{Ser}: U8.D2 (GR_PCLK1_0/PB34A); also elsewhere on the board
/FPGA/GPIO1_{Ser}: U8.G2 (PB38C); also elsewhere on the board
/FPGA/GPIO2_{Ser}: U8.G1 (PB38D); also elsewhere on the board
/FPGA/GPIO3_{Ser}: U8.H1 (MIPI_CLKC1_0/PB34D); also elsewhere on the board
/FPGA/LED: D2.2 (A), U8.D1 (PB34B)
/FPGA/PDB_{Ser}: U8.H2 (MIPI_CLKT1_0/PB34C); also elsewhere on the board
/FPGA/SCLK_{Flash}/TDO: J3.3, J5.5 (TDO), U8.F1 (SPI_SCK/MCK/SDA/PB53), U11.6 (CLK)
/FPGA/SCL_{Ser}: U8.G5 (PCLKC1_0/PB29B); also elsewhere on the board
/FPGA/SDA_{Ser}: U8.H4 (PCLKC1_1/PB29D); also elsewhere on the board
/FPGA/TDI: J3.9, J5.4 (TDI), U8.C3 (PCLKT0_0/USER_SDA/PB47)
/FPGA/~CS_{Flash}: J3.6, JP1.2 (B), R14.2, TP9.1, U8.D3 (SPI_SS/CSN/SCL/PB52)
GND: C42.2, C43.2, C44.2, C45.2, C46.2, C47.2, C48.2, C49.2, C50.2, C51.2, C52.2, C53.2, C54.2, C55.2, C56.2, C57.2, C58.2, J3.2, J3.10, J5.1 (GND), R25.2, SW1.2, U8.C6 (GNDA_DPHYx), U8.D4 (GND), U8.E5 (GND), U8.F5 (GND), U11.4 (GND), U11.9 (GND), U12.2 (GND); also elsewhere on the board
unnamed: C44.1, C52.1, L11.1, U8.G4 (VCCGPLL)
unnamed: C45.1, C53.1, L12.1, U8.C4 (VCCPLL_DPHYx_)
unnamed: C46.1, C54.1, L13.1, U8.C5 (VCCA_DPHYx)
unnamed: C47.1, C55.1, L14.1, U8.F3 (VCCIO0)
unnamed: C48.1, C56.1, L15.1, U8.F4 (VCCIO1)
unnamed: C49.1, C57.1, L16.1, U8.E6 (VCCIO2), U8.F6 (VCCIO2)
unnamed: C51.1, L10.1, U8.D6 (VCCAUX)
unnamed: D2.1 (K), R25.1
unnamed: JP1.1 (A), U11.1 (~CS)
unnamed: R21.2, U11.7 (~HOLD/IO_{3})
unnamed: R22.2, U11.3 (~WP/IO_{2})

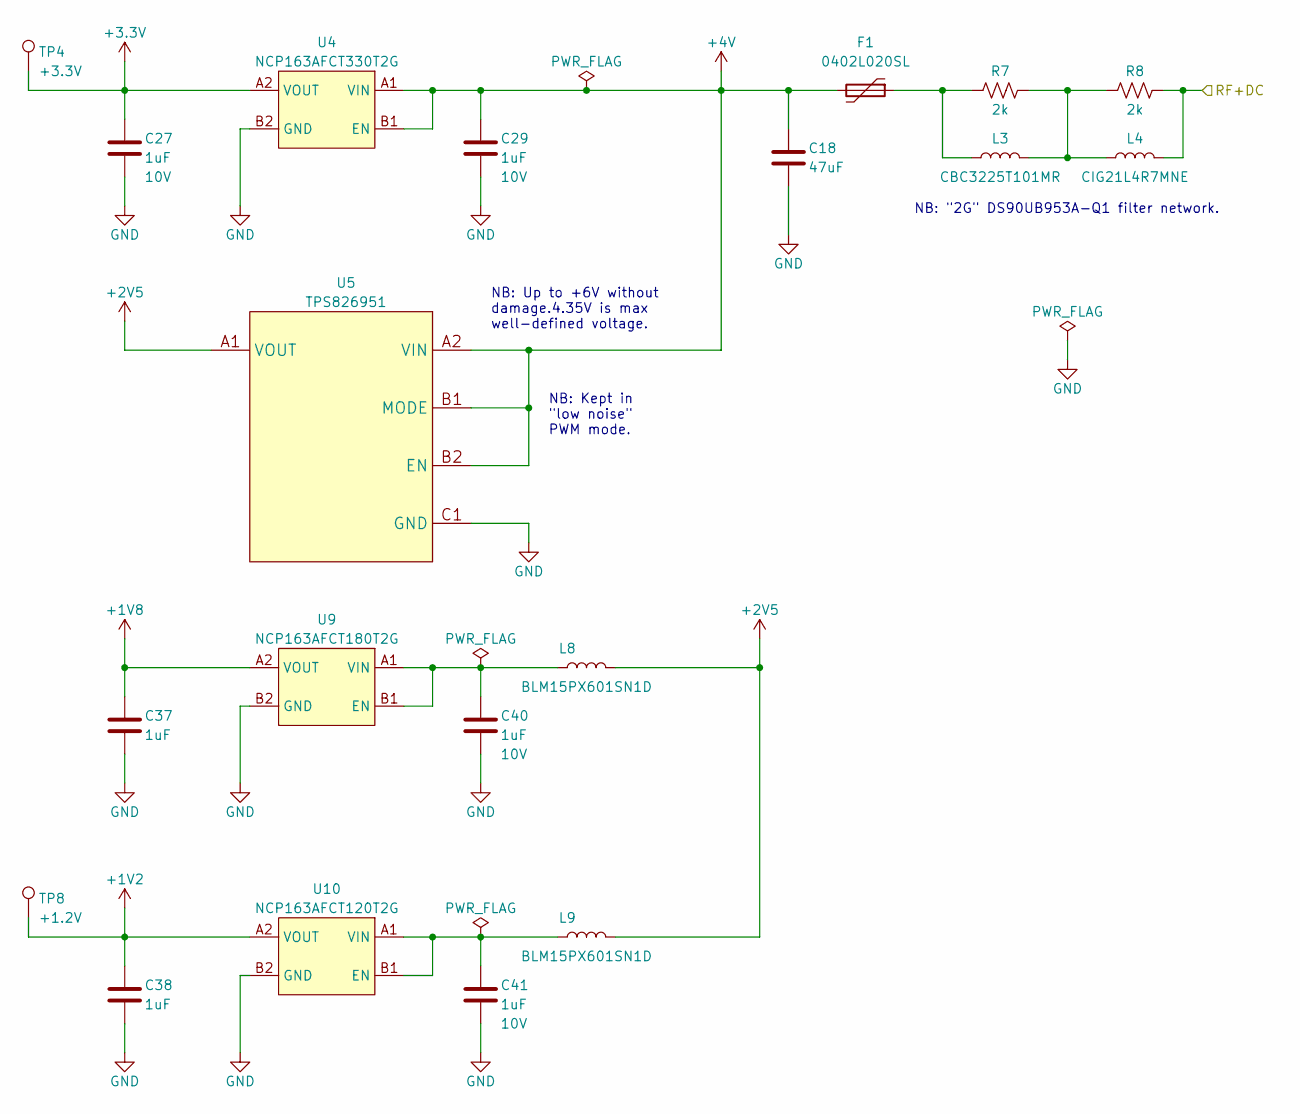
[picture p12: schematic power.kicad_sch, Headstage-64s]

Parts:
C18: 47uF; C_0805_2012Metric; Voltage 10V
C27, C29, C37, C38, C40, C41: 1uF; C_0201_0603Metric; Voltage 10V
F1: 0402L020SL; LITTLEFUSE_0402
L3: CBC3225T101MR; L_1210_3225Metric
L4: CIG21L4R7MNE; L_0805_2012Metric
L8, L9: BLM15PX601SN1D; L_0402_1005Metric
R7, R8: 2k; R_0201_0603Metric
TP4: +3.3V; TestPoint_Pad_D0.6mm
TP8: +1.2V; TestPoint_Pad_D0.6mm
U4: NCP163AFCT330T2G; ONSEMI_567JZ_WLCSP4-0.64x0.64
U5: TPS826951; TI_SIP0008B
U9: NCP163AFCT180T2G; ONSEMI_567JZ_WLCSP4-0.64x0.64
U10: NCP163AFCT120T2G; ONSEMI_567JZ_WLCSP4-0.64x0.64

Connections:
+1V2: C38.1, TP8.1, U10.A2 (VOUT); also elsewhere on the board
+1V8: C37.1, U9.A2 (VOUT); also elsewhere on the board
+2V5: L8.2, L9.2, U5.A1 (VOUT); also elsewhere on the board
+3V3: C27.1, TP4.1, U4.A2 (VOUT); also elsewhere on the board
+4V: C18.1, C29.1, F1.2, U4.A1 (VIN), U4.B1 (EN), U5.A2 (VIN), U5.A3 (VIN), U5.B1 (MODE), U5.B2 (EN); also elsewhere on the board
/DC Tap & Regulation/RF+DC: L4.1, R8.2; also elsewhere on the board
GND: C18.2, C27.2, C29.2, C37.2, C38.2, C40.2, C41.2, U4.B2 (GND), U5.C1 (GND), U5.C2 (GND), U5.C3 (GND), U9.B2 (GND), U10.B2 (GND); also elsewhere on the board
unnamed: C40.1, L8.1, U9.A1 (VIN), U9.B1 (EN)
unnamed: C41.1, L9.1, U10.A1 (VIN), U10.B1 (EN)
unnamed: F1.1, L3.1, R7.1
unnamed: L3.2, L4.2, R7.2, R8.1

Notes on the sheet:
NB: Kept in "low noise" PWM mode.
NB: "2G" DS90UB953A-Q1 filter network.
NB: Up to +6V without damage.4.35V is max well-defined voltage.
