open-ephys/onix-headstage-64s/pcb/headstage-64s.kicad_pcb

## KiCad design pcb/headstage-64s.kicad_pcb (continued)

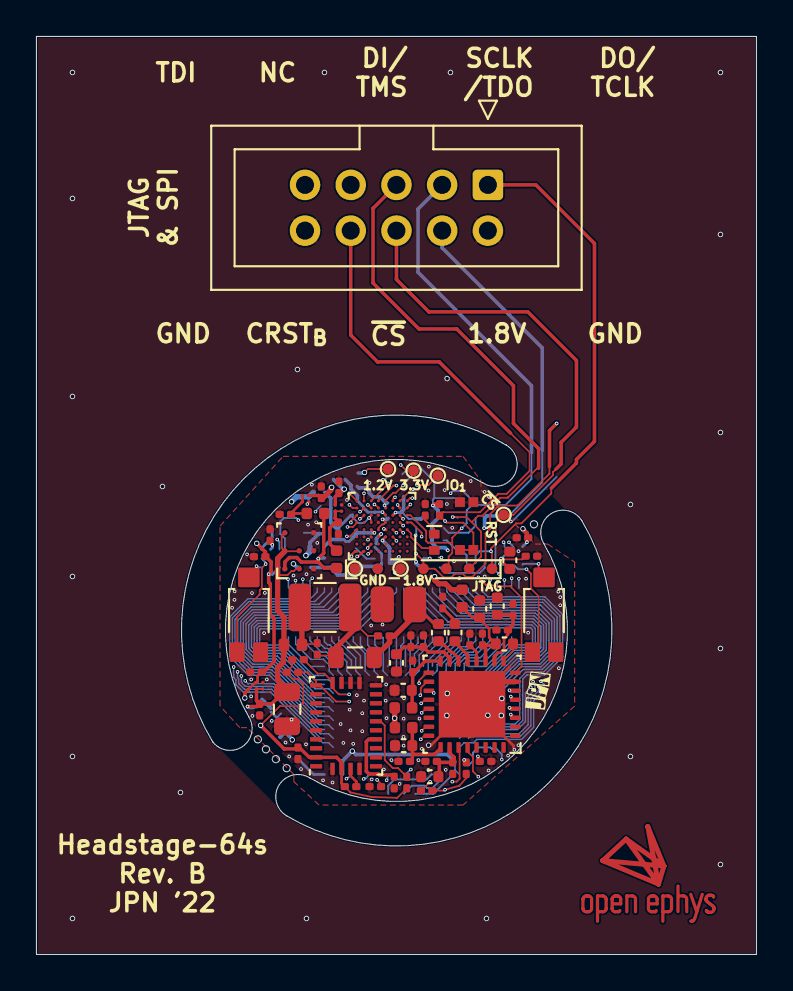
[picture p13: board headstage-64s.kicad_pcb from above]

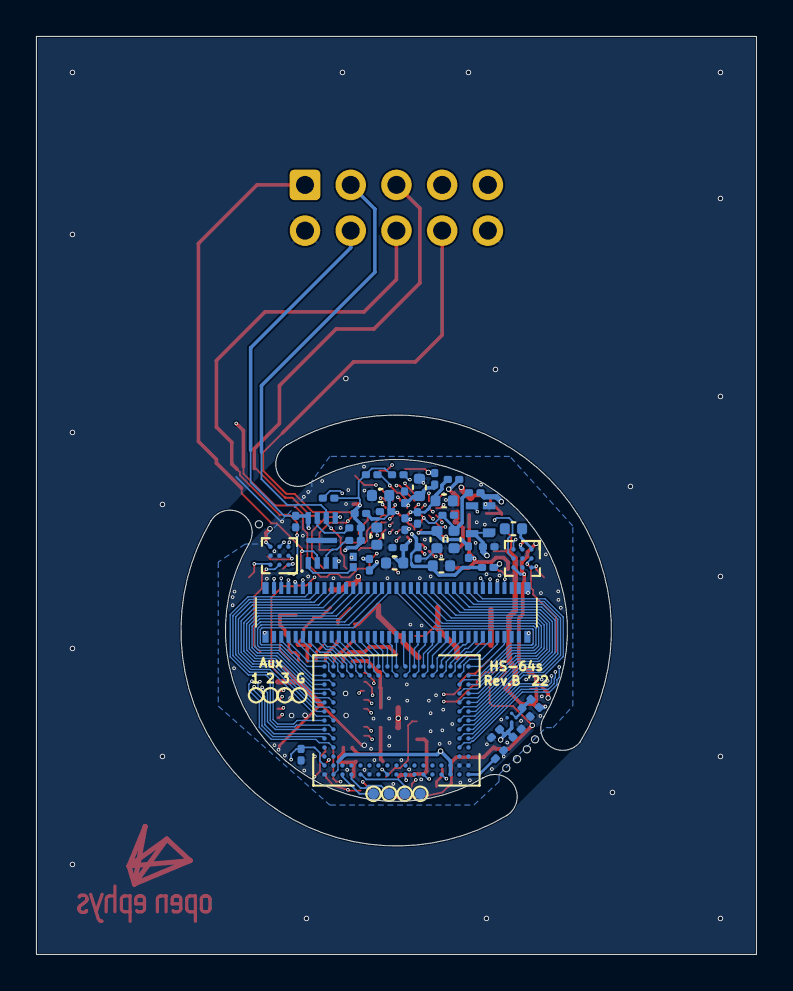
[picture p14: board headstage-64s.kicad_pcb from below]

Board: 6 copper layers, 40.0 x 51.0 mm, 120 parts (48 on the bottom side), 147 nets.
