open-ephys/onix-headstage-64s/(commit log)

2022-01-18 Initial PCB design
    - This is a simplfied version of
    https://github.com/open-ephys/onix-headstage-64
    - Has the same features except for optical and electrical stimulation
    - Will need iterations when finalizing BOM and manufacturing details.
    - Targetting speedy 6-layer 0.6mm thick board. Epoxy filled and plated
    vias would be optimal, but I think I can get away without doing that.
    [ephys.kicad_sch, fpga.kicad_sch, headstage-64s.kicad_pcb, headstage-64s.kicad_sch, power.kicad_sch, serializer.kicad_sch]
2022-01-23 Added coax-adapter sub-board
    - 2-layer coaxial adapter sub-board for getting RA mount tether
    connection with integrated strain relief
    - The.step file is used for the 3D model in the local
    pcb/footprint/Coax-Adapter.kicad_mod
    - Local pcb/footprint/Castellation.kicad_mod is used for the castellated
    connectors on the coax-adapter itself
    - The gerber folder contains the panelized version of the coax-adapter
    [headstage-64s-coax-adapter.kicad_pcb, headstage-64s-coax-adapter.kicad_sch, headstage-64s-coax-adapter.step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]
2022-01-23 Delete extra drill file
    - Mistakenly added in last commit
    [headstage-64s-coax-adapter_panel-PTH.xln]
2022-01-25 Rev. A initial design prior to fab comments
    - BOM simplification
    - Added my initials to the board
    - Made the board more easy to panlize
    [3d-pose.kicad_sch, ephys.kicad_sch, fpga.kicad_sch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]
2022-01-25 Added headstage-64s BOM
2022-03-02 Small changes before speedy fabrication
    - This is revision A
    [fpga.kicad_sch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]
2022-12-06 Start of revision B
    - Address the following issues
    1. The photodiode anode is on pin 3, not pin 2
    2. No paste on coax connector
    3. CRESET_B needs to come out to programming header
    4. Need PU on CS line.
    [3d-pose.kicad_sch, ephys.kicad_sch, fpga.kicad_sch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]
2022-12-06 Add a couple of missing files
    [headstage-64s.csv]
2022-12-09 Remove coax-adapter pcb
    - It has been moved to its own repo since its used by several projects
    [headstage-64s-coax-adapter.kicad_pcb, headstage-64s-coax-adapter.kicad_sch, headstage-64s-coax-adapter.step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]
2023-01-05 PCB revision B
    - Added production files sent from Speedy
    [headstage-64s-PTH-drl_map.gbr]
